Franky55/A24_ruler_Automne_2024/C3I_Equipe2_Documentation/TEMPLATE_A24.pptx

Ruler 2024

Présentation par : équipe 2
Laurie-Anne Boudreault
Francis Gratton
Groupe technique C3I

## Déroulement de la présentation

C3I – Équipe 2

Présentation
générale du projet

1

Présentation du projet

2

Respect des
contraintes

3

Gestion

4

5

Période de questions

6

Démonstration

## Présentation globale

- Tanné d’avoir plusieurs outils à trainer?

Ton professeur d’architecture est dégouté par tes projets avec des angles dégueu?

Fatigué que tes projets de bricolo ne fonctionnent pas?

Ruler 2024 est alors parfait pour toi!

## Présentation globale

- Avantages
- Amélioration de la productivité
- Réduction des outils nécessaires
- Meilleur rapport qualité-prix
- Adapté aux professionnels et étudiants
- Caractéristiques
- Traçage précis
- Mesure d’angles intégrée
- Ergonomique
- Portable
- Cibles
- Architectes
- Designers
- Bricoleurs

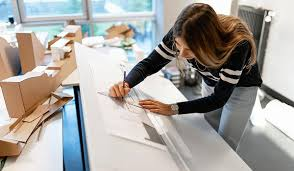
[picture p1: figure]
Structured for Success: Bachelor of Architecture - News - Truckee Meadows Community College
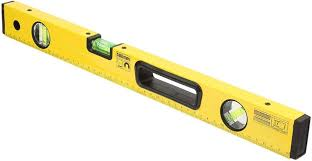
[picture p2: figure]
Règle de niveau à bulle en alliage d'aluminium haute précision 500 mm : Amazon.ca: Outils et Bricolage
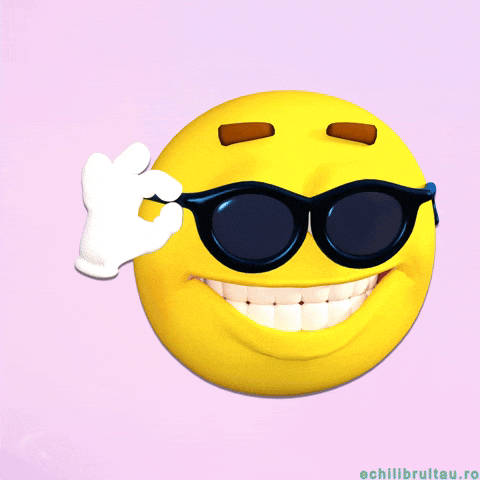
[picture p3: figure]
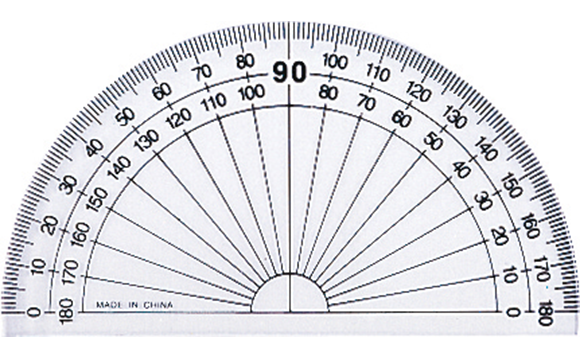
[picture p4: figure]
Rapporteur d'angles semi-circulaire - Brault & Bouthillier
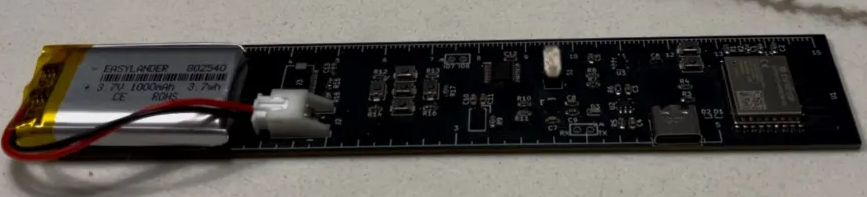
[picture p5: figure]

## Déroulement de la présentation

Présentation
générale du projet

1

Présentation du projet

2

Respect des
contraintes

3

Gestion

4

5

Période de questions

6

Démonstration

## Fonctionnalités

- ESP32-C3 WROOM
- USB-C (Prog et recharge)
- Sensor de distance
- IMU
- Battery 3.7V (Lithium Polymer)

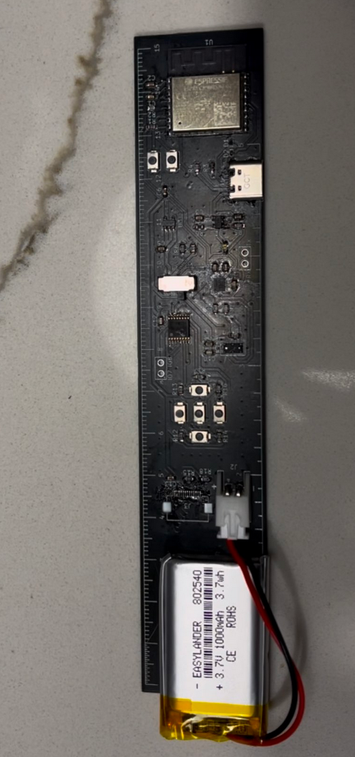
[picture p6: figure]

## Slide 7

Sample Footer Text

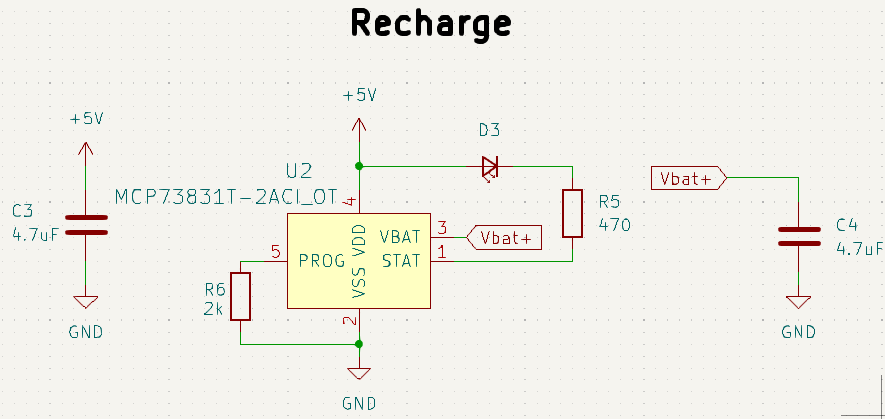
[picture p7: figure]
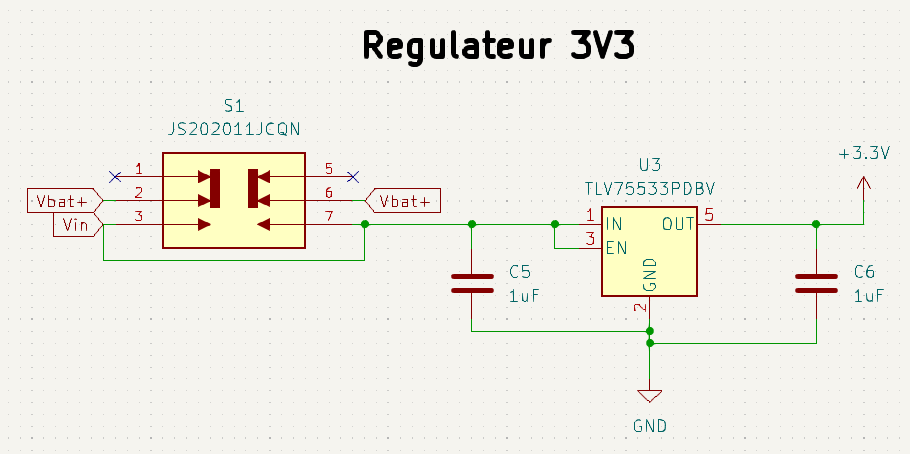
[picture p8: figure]

## Slide 8

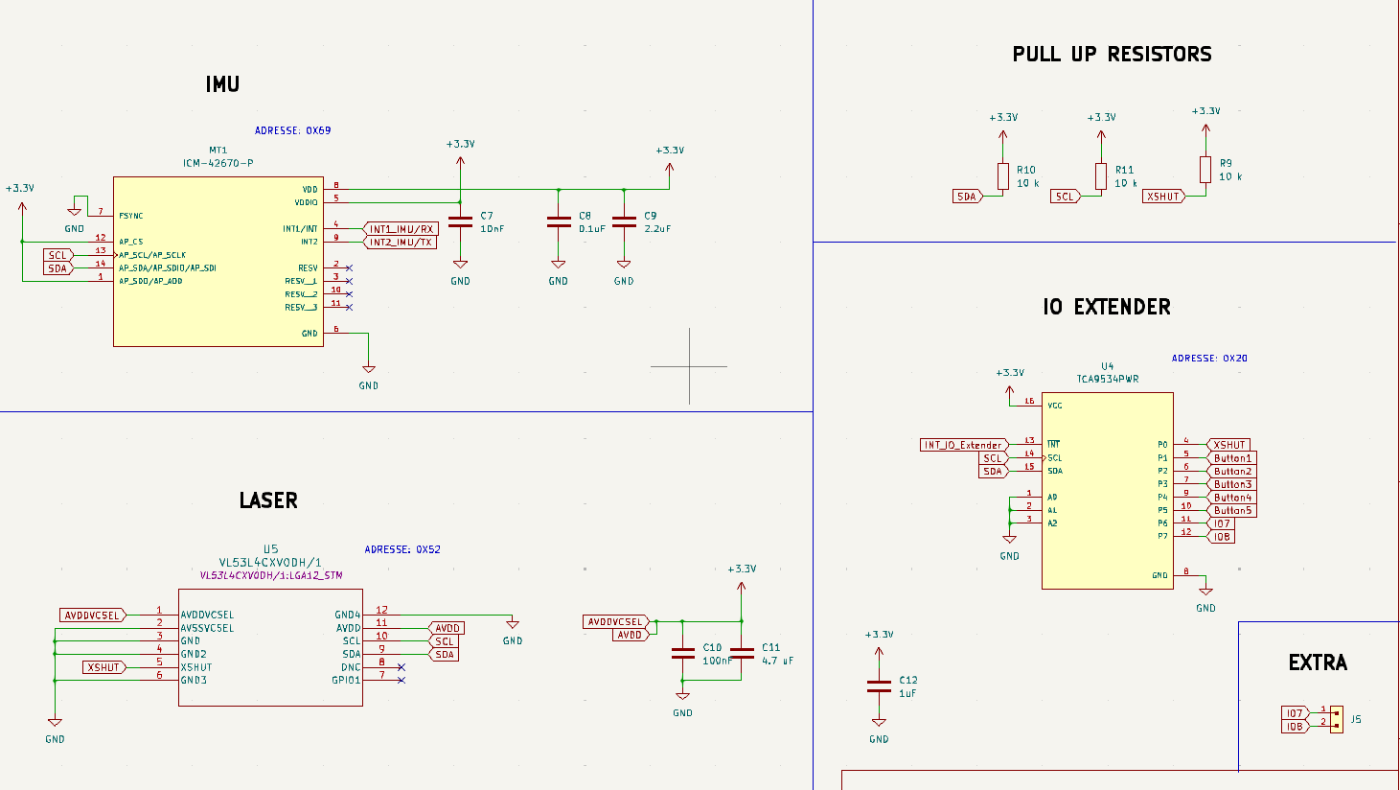
[picture p9: figure]

## Slide 9

Couche du dessous:

Couche du dessus:

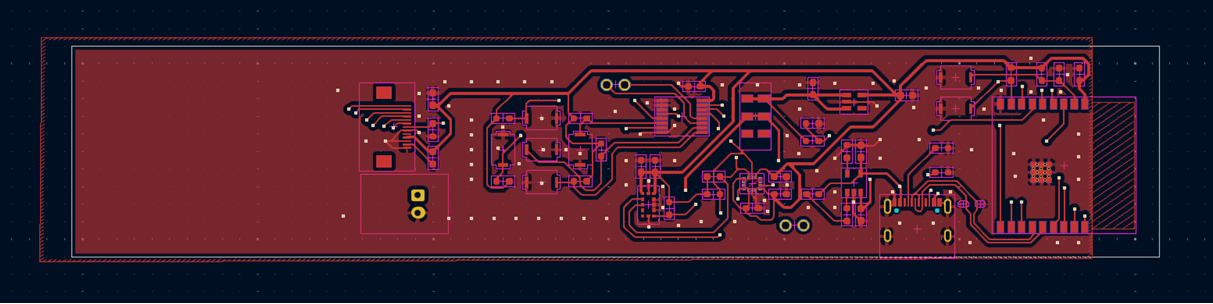
[picture p10: figure]
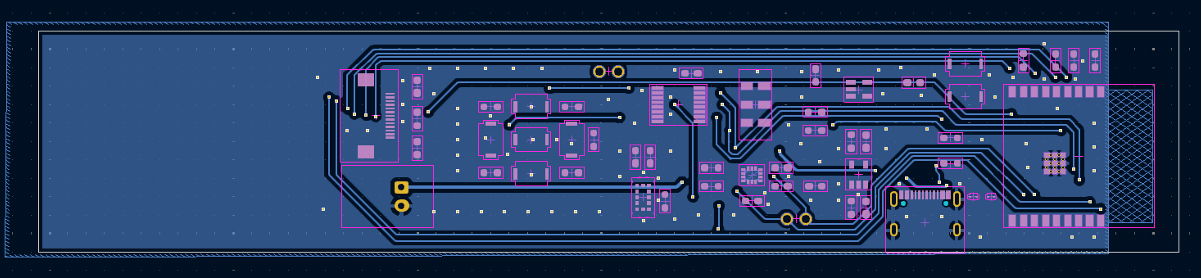
[picture p11: figure]

## Déroulement de la présentation

Présentation
générale du projet

1

Présentation du projet

2

Respect des
contraintes

3

Gestion

4

5

Période de questions

6

Démonstration

## Respect des contraintes

- Échéanciers
- Coût de développement
- Dimension

Coût du BOM

## Déroulement de la présentation

Présentation
générale du projet

1

Présentation du projet

2

Respect des
contraintes

3

Gestion

4

5

Période de questions

6

Démonstration

## Gestion

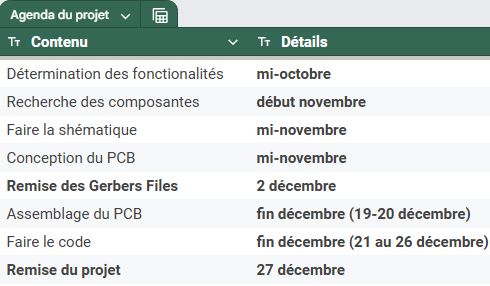
[picture p12: figure]

**Une moyenne de 3h par semaine a été accordée au projet.

## Déroulement de la présentation

Présentation
générale du projet

1

Présentation du projet

2

Respect des
contraintes

3

Gestion

4

5

Période de questions

6

Démonstration

## Déroulement de la présentation

Présentation
générale du projet

1

Présentation du projet

2

Respect des
contraintes

3

Gestion

4

5

Période de questions

6

Démonstration
