Franky55/A24_ruler_Automne_2024/C3I_Equipe2_Documentation/Bom/PCB_Regle_2024_ExcelCommande.pdf

Description | Component | for what | Part's Name | Part's Type | Price Per Unit | Quantity | Total | Manufacturer's ID | Digikey's ID | JLC's ID | Buying Link
| IMU | angle | ICM-42670-P | Sensor | $5.31 | 1 | $5.31 | ICM-42670-P | 1428-ICM-42670-PCT-ND | | https://www.digikey.ca/en/products/detail/tdk-invensense/ICM-42670-P/14319524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
| | | ESP32-C3-WROOM- 02-H4 | Microcontroller | $3.13 | 1 | $3.13 | ESP32-C3-WROOM- 02-H4
1965-ESP32-C3-WROOM- 02-H4CT-ND | https://www.digikey.ca/en/products/detail/espressif-systems/ESP32-C3-WROOM-02-H4/14553033 Chargeur pour la battery | Chargeur | For Battery | MCP73831T-2ACI/OT | Component | $1.19 | 1 | $1.19 | MCP73831T-2ACI/OT | MCP73831T-2ACI/OTCT-ND | https://www.digikey.com/en/products/detail/microchip-technology/MCP73831T-2ACI-OT/964301 CAP CER 0.1UF 50V X7R 0603 | CAP 0.1uF | IMU | Capacitor | Component | $0.04 | 10 | $0.37 | CL10B104KB8NNNC | 1276-1000-1-ND | https://www.digikey.ca/en/products/detail/samsung-electro-mechanics/CL10B104KB8NNNC/3886658 CAP CER 2.2UF 16V X5R 0603 | CAP 2.2uF | IMU | Capacitor | Component | $0.04 | 10 | $0.37 | CL10A225KO8NNNC | 1276-1040-1-ND | https://www.digikey.ca/en/products/detail/samsung-electro-mechanics/CL10A225KO8NNNC/3886698 CAP CER 10000PF 50V X7R 0603 | CAP 10nF | IMU | Capacitor | Component | $0.04 | 10 | $0.37 | CL10B103KB8NNNC | 1276-1009-1-ND | https://www.digikey.ca/en/products/detail/samsung-electro-mechanics/CL10B103KB8NNNC/3886667
IC REG LINEAR 3.3V 500MA SOT23-5 | Regulator 3.3V | Voltage 3.3V | Regulator 3.3V | Component | $0.32 | 2 | $0.64 | TLV75533PDBVR | 296-50411-1-ND | https://www.digikey.ca/en/products/detail/texas-instruments/TLV75533PDBVR/9356541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
laser | | distance mesuring | VL53L4CXV0DH/1 | Sensor | $6.97 | 1 | $6.97 | VL53L4CXV0DH/1
497-VL53L4CXV0DH/1CT- ND | https://www.digikey.ca/en/products/detail/stmicroelectronics/VL53L4CXV0DH-1/16123777 CONN HEADER R/A 2POS 2.5MM | Connecteur batt Connecteur batt | S2B-XH-A-1 | Connector | $0.31 | 1 | $0.31 | S2B-XH-A-1 | 455-S2B-XH-A-1-ND | https://www.digikey.ca/en/products/detail/jst-sales-america-inc/S2B-XH-A-1/9961922 CONN RCP USB2.0 TYP C 24P SMD RA | USB-C | Connecting | USB4105-GF-A | Connector | $1.53 | 1 | $1.53 | USB4105-GF-A | 2073-USB4105-GF-ACT-ND | https://www.digikey.ca/en/products/detail/gct/USB4105-GF-A/11198441
IC XPNDR 400KHZ I2C 16TSSOP | I/O Expander | Manque de I/O | TCA9534PWR | Component | $1.88 | 1 | $1.88 | TCA9534PWR | 296-40574-1-ND | https://www.digikey.ca/en/products/detail/texas-instruments/TCA9534PWR/5004966 SWITCH TACTILE SPST-NO 0.05A 50V | Button | Screen/Boot/reset | CS1213AGF260 | Component | $0.63 | 7 | $4.41 | CS1213AGF260 | 2449-CS1213AGF260CT-ND | https://www.digikey.ca/en/products/detail/cit-relay-and-switch/CS1213AGF260/16607763 SWITCH SLIDE DPDT 300MA 6V | Switch | Power ON/OFF | JS202011JAQN | Component | $1.30 | 1 | $1.30 | JS202011JAQN | CKN10722CT-ND | https://www.digikey.ca/en/products/detail/c-k/JS202011JAQN/6137629 TVS DIODE 5VWM 12.3VC SOD923 | TVS | Protection ;) | ESD9X5.0ST5G | Component | $0.15 | 2 | $0.30 | ESD9X5.0ST5G | ESD9X5.0ST5GOSCT-ND | https://www.digikey.ca/en/products/detail/onsemi/ESD9X5-0ST5G/1476616
LED GREEN CLEAR 0603 SMD | LED | Chargement | 150060VS75000 | Component | $0.23 | 1 | $0.23 | 150060VS75000 | 732-4980-1-ND | https://www.digikey.ca/en/products/detail/w%C3%BCrth-elektronik/150060VS75000/4489906
resistance 10K | resistor | resistor | RC0603FR-0710KL | Component | $0.02 | 10 | $0.19 | RC0603FR-0710KL | 311-10.0KHRCT-ND | https://www.digikey.ca/en/products/detail/yageo/RC0603FR-075K1L/727268
resistance 5k | resistor | resistor | RC0603FR-075K1L | Component | $0.02 | 10 | $0.19 | RC0603FR-075K1L | 311-5.10KHRCT-ND | https://www.digikey.ca/en/products/detail/yageo/RC0603FR-075K1L/727268
resistance 2k | resistor | resistor | ERJ-3EKF2001V | Component | $0.16 | 1 | $0.16 | ERJ-3EKF2001V | P2.00KHCT-ND | https://www.digikey.ca/en/products/detail/yageo/RC0603FR-075K1L/727268
resistance 100k | resistor | resistor | RMCF0603FT100K | Component | $0.16 | 1 | $0.16 | RMCF0603FT100K | RMCF0603FT100KCT-ND | https://www.digikey.ca/en/products/detail/yageo/RC0603FR-075K1L/727268
resistance 300k | resistor | resistor | RMCF0603FT300K | Component | $0.16 | 1 | $0.16 | RMCF0603FT300K | RMCF0603FT300KCT-ND | https://www.digikey.ca/en/products/detail/yageo/RC0603FR-075K1L/727268
resistance 470 ohms | resistor | resistor | RC0603JR-07470RL | Component | $0.02 | 10 | | RC0603JR-07470RL | 311-470GRCT-ND | https://www.digikey.ca/en/products/detail/yageo/RC0603JR-07470RL/726791
resistance 20-25 ohms | resistor | resistor | RC0603JR-0720RL | Component | $0.02 | 10 | | RC0603JR-0720RL | 311-20GRCT-ND | https://www.digikey.ca/en/products/detail/yageo/RC0603JR-0720RL/726739
resistance 0 ohms | resistor | resistor | RMCF0603ZT0R00 | Component | $0.02 | 10 | $0.20 | RMCF0603ZT0R00 | RMCF0603ZT0R00CT-ND | https://www.digikey.ca/en/products/detail/stackpole-electronics-inc/RMCF0603ZT0R00/1756908
capacitor 4,7 uF | capacitor | capacitor | CL10A475KP8NNNC Component | $0.05 | 10 | CL10A475KP8NNNC 1276-1044-1-ND | https://www.digikey.ca/en/products/detail/samsung-electro-mechanics/CL10A475KP8NNNC/3886702
capacitor 1uF | capacitor | capacitor | CL10B105KP8NNNC | Component | $0.05 | 10 | $0.47 | CL10B105KP8NNNC 1276-1946-1-ND | https://www.digikey.ca/en/products/detail/samsung-electro-mechanics/CL10B105KP8NNNC/3887604
total | $29.84
