Franky55/A24_ruler_Automne_2024/C3I_Equipe2_Documentation/SchematicRuler2024FrankLau.pdf

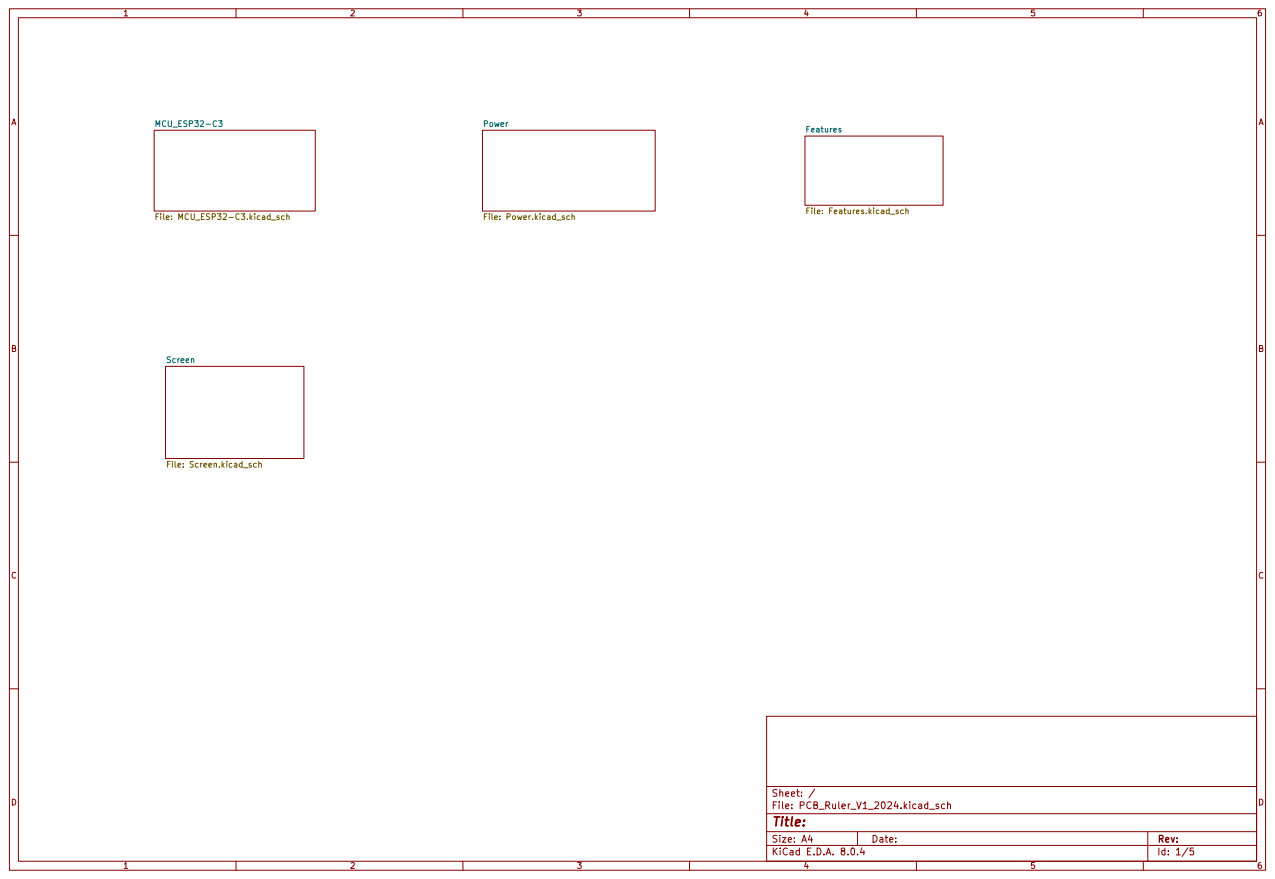
[picture p22: page 1]

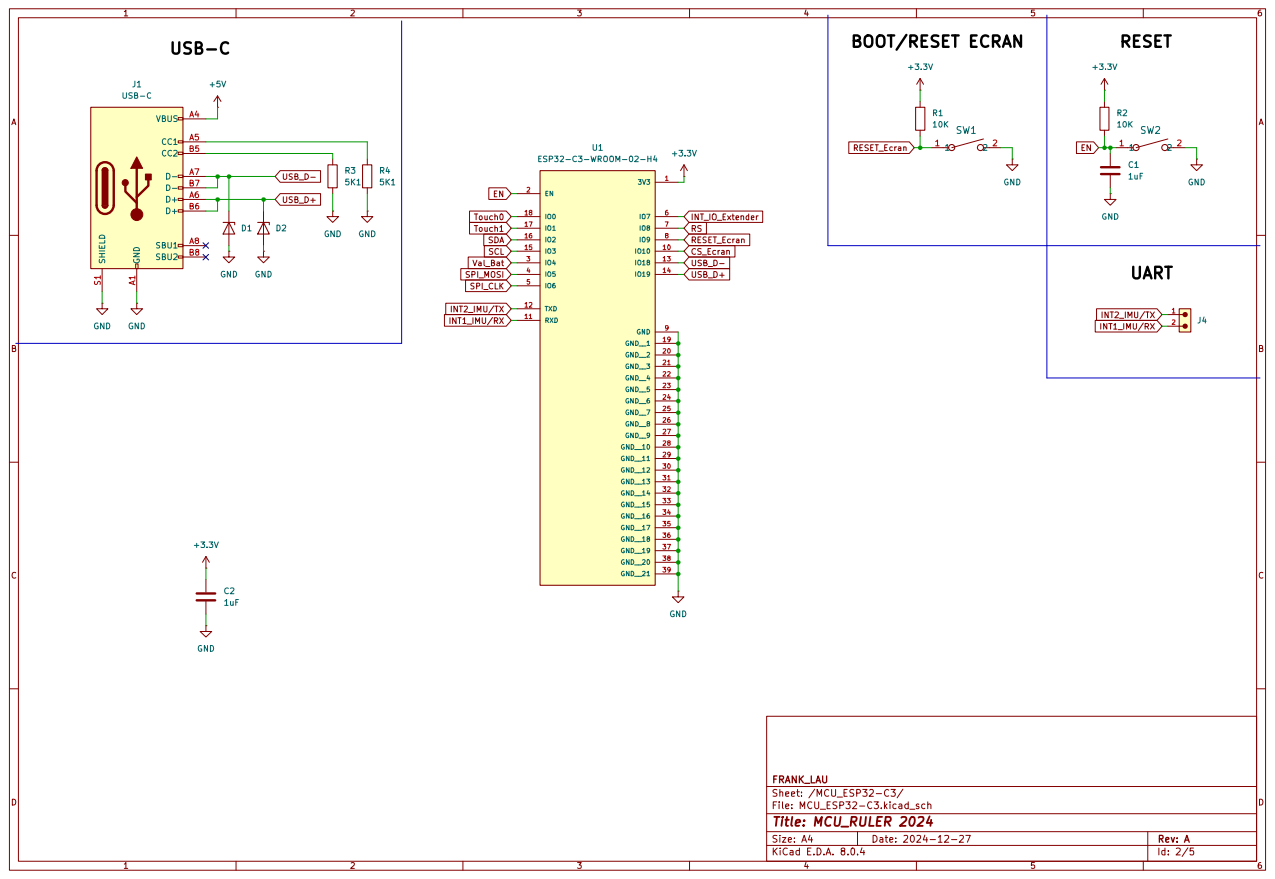
[picture p23: page 2]

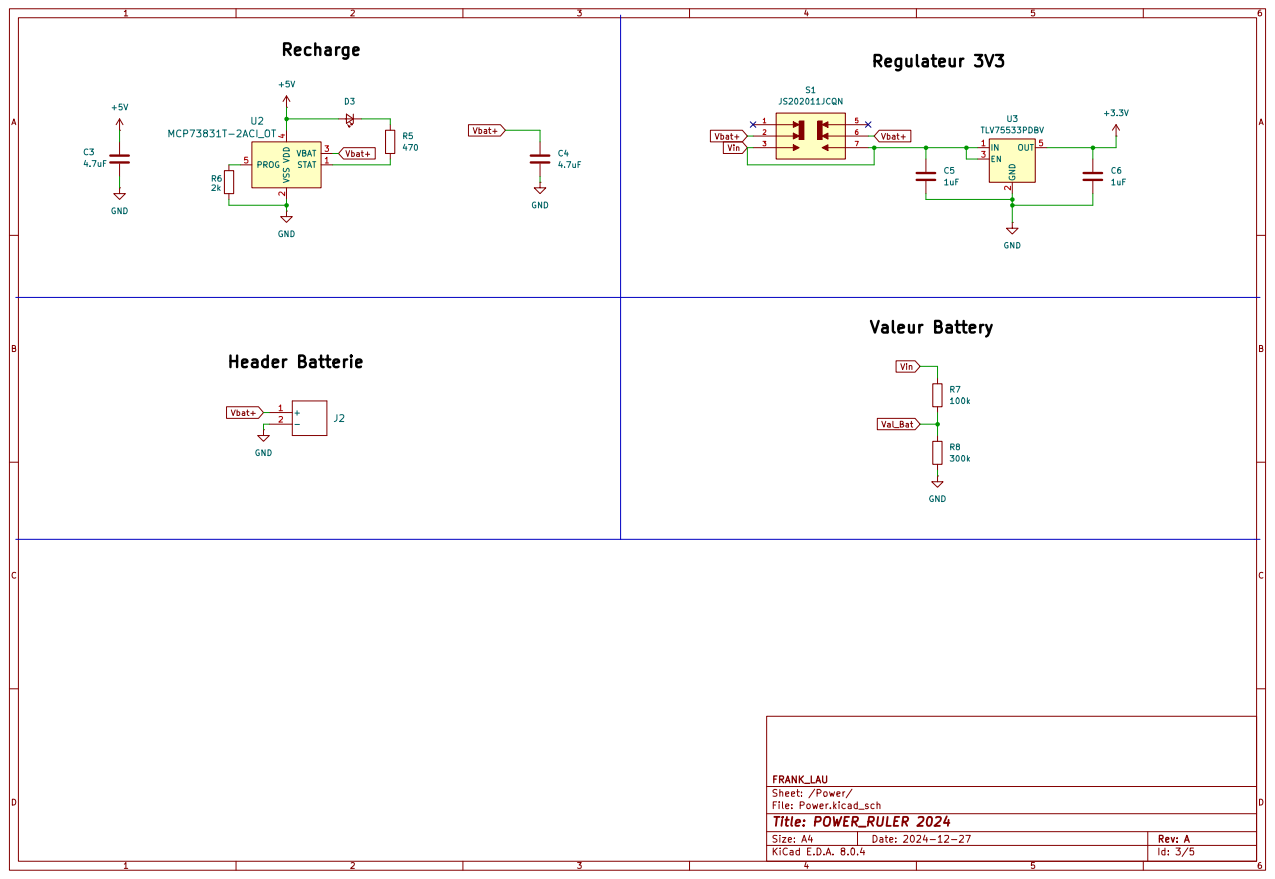
[picture p24: page 3]

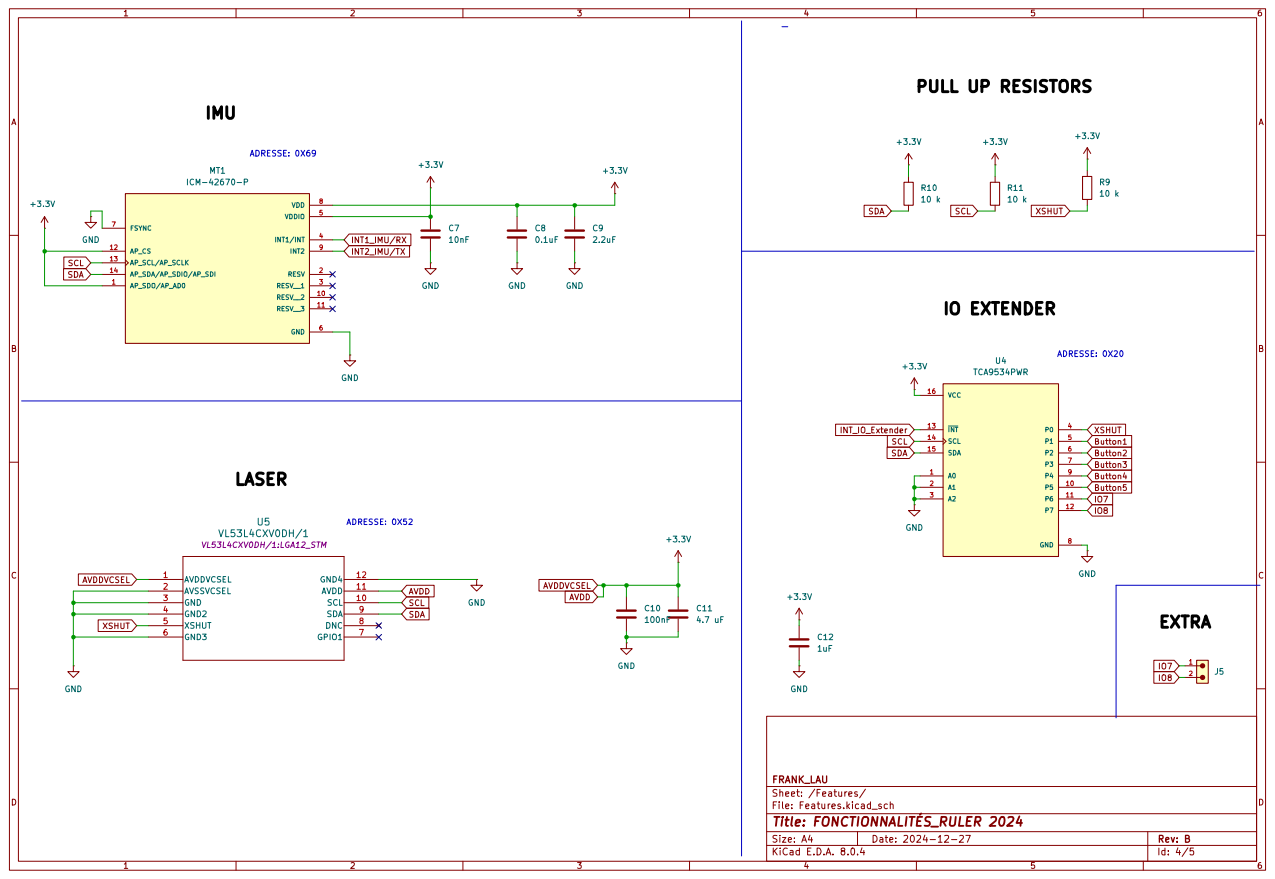
[picture p25: page 4]

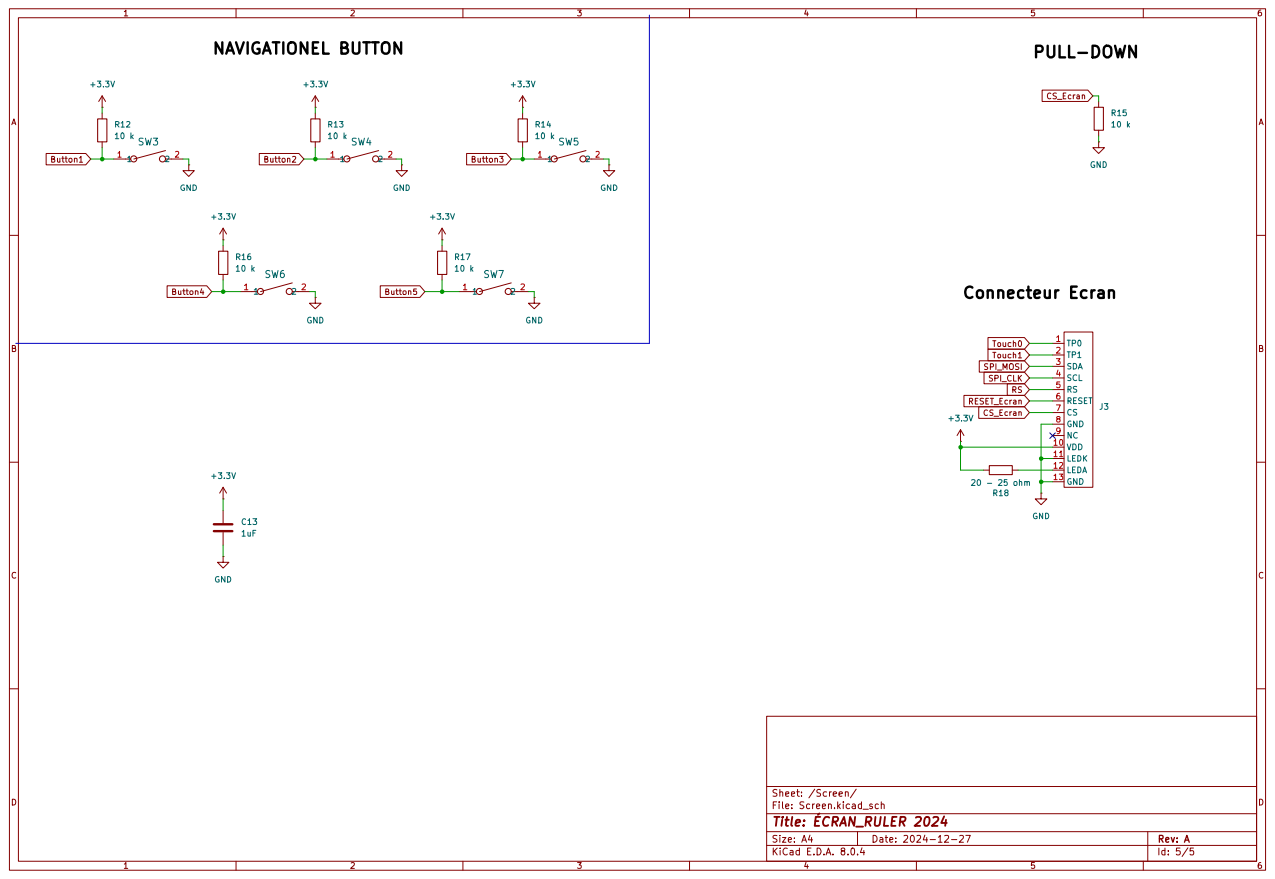
[picture p26: page 5]
