Franky55/A24_ruler_Automne_2024/elec/PCB_Ruler_V1_2024/PCB_Ruler_V1_2024.kicad_pcb

## KiCad design elec/PCB_Ruler_V1_2024/PCB_Ruler_V1_2024.kicad_pcb (2024-12-28)

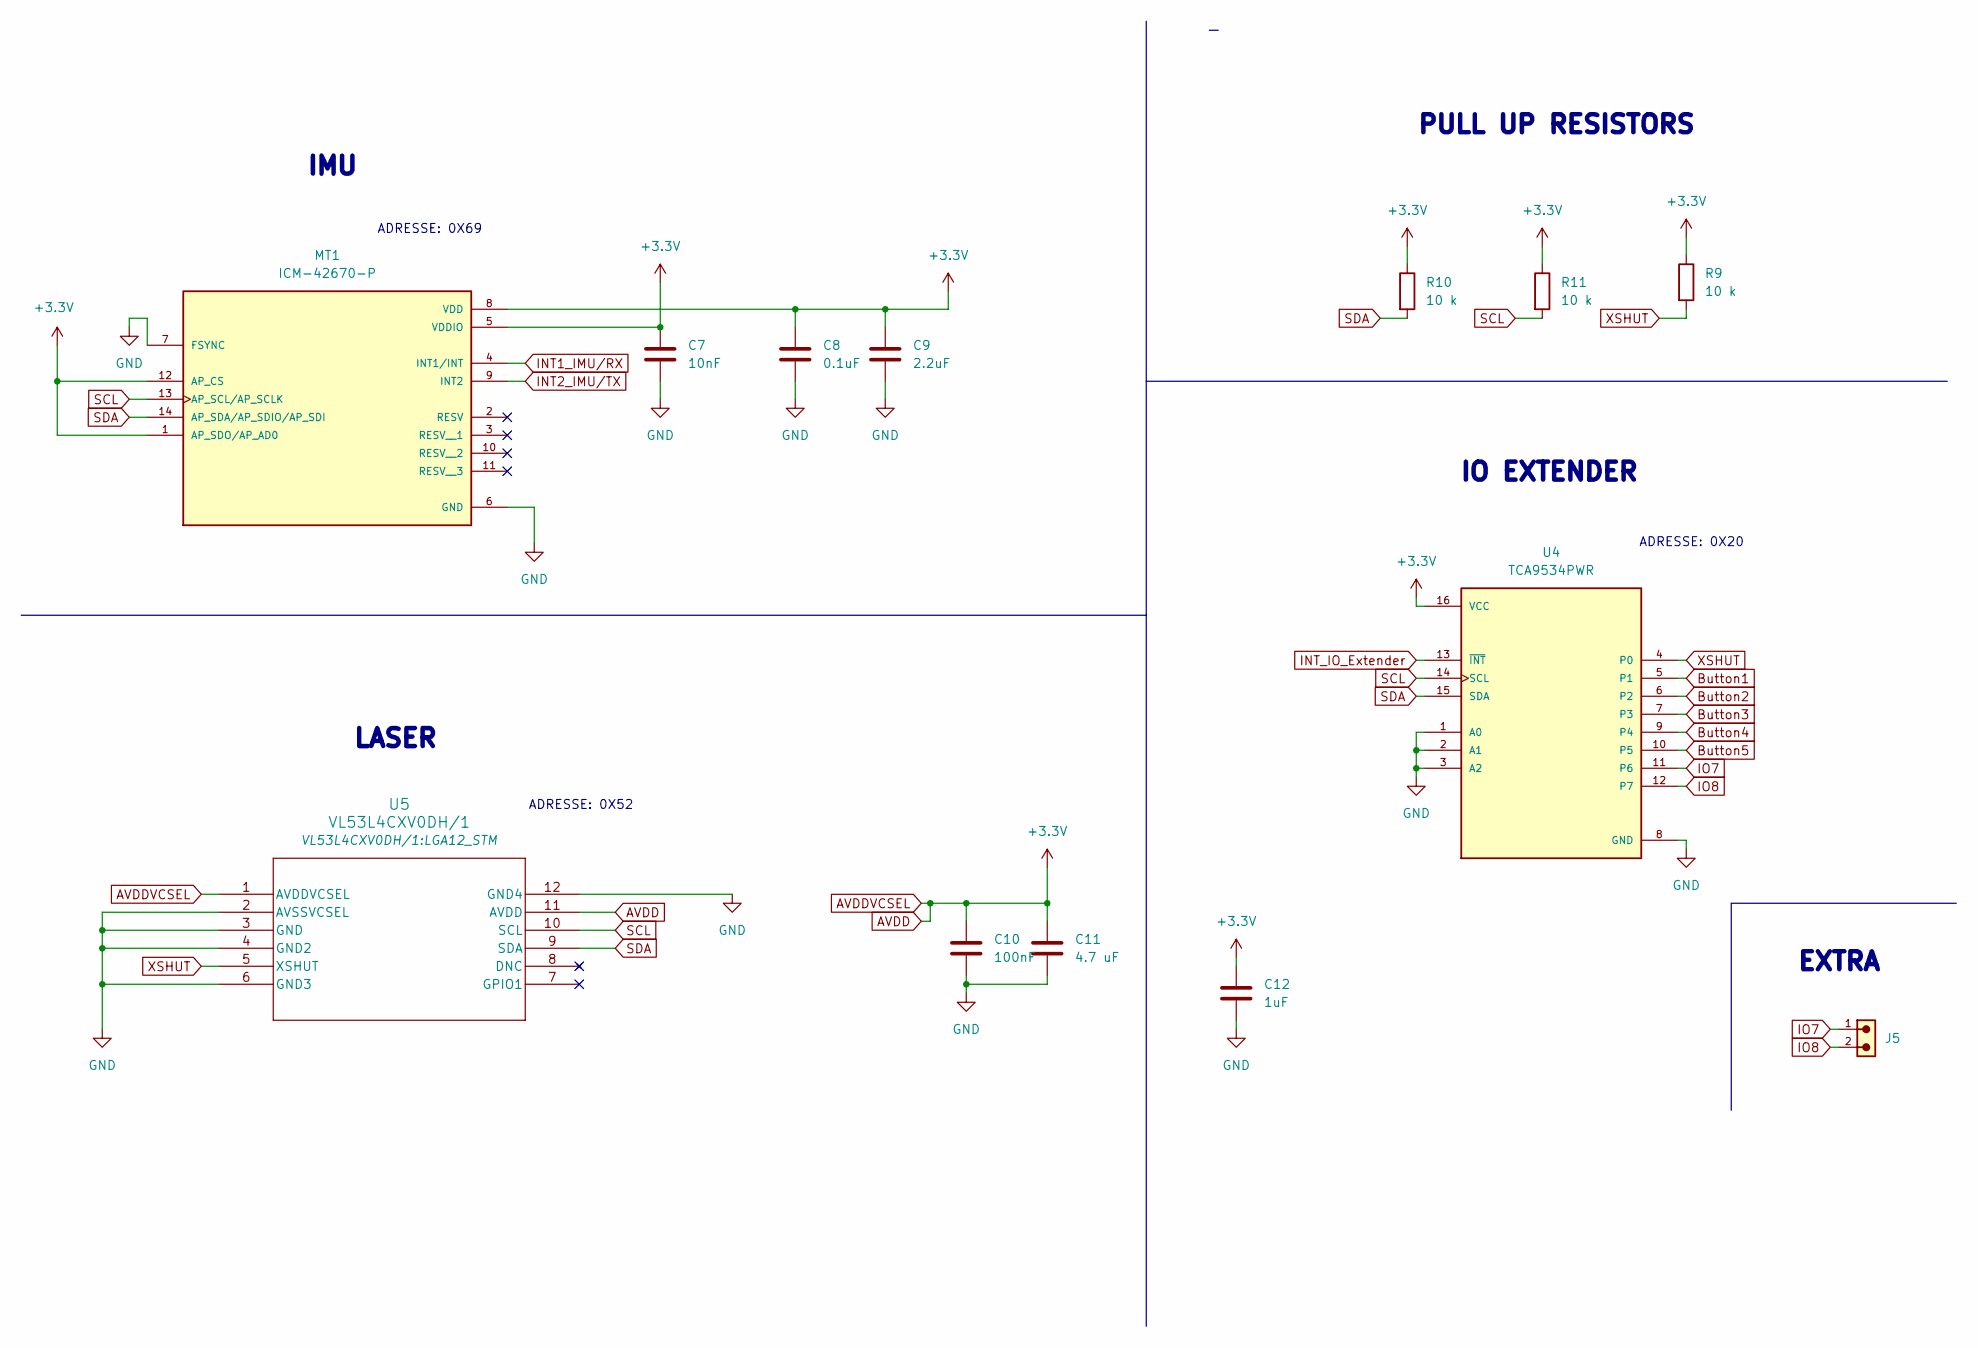
[picture p27: schematic Features.kicad_sch, FONCTIONNALITÉS_RULER 2024]

Parts:
C7: 10nF; C_0603_1608Metric_Pad1.08x0.95mm_HandSolder
C8: 0.1uF; C_0603_1608Metric_Pad1.08x0.95mm_HandSolder
C9: 2.2uF; C_0603_1608Metric_Pad1.08x0.95mm_HandSolder
C10: 100nF; C_0603_1608Metric_Pad1.08x0.95mm_HandSolder
C11: 4.7 uF; C_0603_1608Metric_Pad1.08x0.95mm_HandSolder
C12: 1uF; C_0603_1608Metric_Pad1.08x0.95mm_HandSolder
J5: 61300211121; PART-NUMBER 61300211121
MT1: ICM-42670-P; XDCR_ICM-42670-P; PARTREV 1.1
R9, R10, R11: 10 k; R_0603_1608Metric_Pad0.98x0.95mm_HandSolder
U4: TCA9534PWR; SOP65P640X120-16N; PARTREV D
U5: VL53L4CXV0DH/1; LGA12_STM

Connections:
AVDD: C7.1, C8.1, C9.1, C10.1, C11.1, C12.1, MT1.1 (AP_SDO/AP_AD0), MT1.5 (VDDIO), MT1.8 (VDD), MT1.12 (AP_CS), R9.1, R10.1, R11.1, U4.16 (VCC), U5.1 (AVDDVCSEL), U5.11 (AVDD); also elsewhere on the board
Button1: U4.5 (P1); also elsewhere on the board
Button2: U4.6 (P2); also elsewhere on the board
Button3: U4.7 (P3); also elsewhere on the board
Button4: U4.9 (P4); also elsewhere on the board
Button5: U4.10 (P5); also elsewhere on the board
GND: C7.2, C8.2, C9.2, C10.2, C11.2, C12.2, MT1.6 (GND), MT1.7 (FSYNC), U4.1 (A0), U4.2 (A1), U4.3 (A2), U4.8 (GND), U5.2 (AVSSVCSEL), U5.3 (GND), U5.4 (GND2), U5.6 (GND3), U5.12 (GND4); also elsewhere on the board
INT1_IMU/RX: MT1.4 (INT1/INT); also elsewhere on the board
INT2_IMU/TX: MT1.9 (INT2); also elsewhere on the board
INT_IO_Extender: U4.13 (~INT); also elsewhere on the board
IO7: J5.1, U4.11 (P6)
IO8: J5.2, U4.12 (P7)
SCL: MT1.13 (AP_SCL/AP_SCLK), R11.2, U4.14 (SCL), U5.10 (SCL); also elsewhere on the board
SDA: MT1.14 (AP_SDA/AP_SDIO/AP_SDI), R10.2, U4.15 (SDA), U5.9 (SDA); also elsewhere on the board
XSHUT: R9.2, U4.4 (P0), U5.5 (XSHUT)

Notes on the sheet:
IMU
ADRESSE: 0X20
ADRESSE: 0X52
ADRESSE: 0X69
IO EXTENDER
LASER
EXTRA
PULL UP RESISTORS

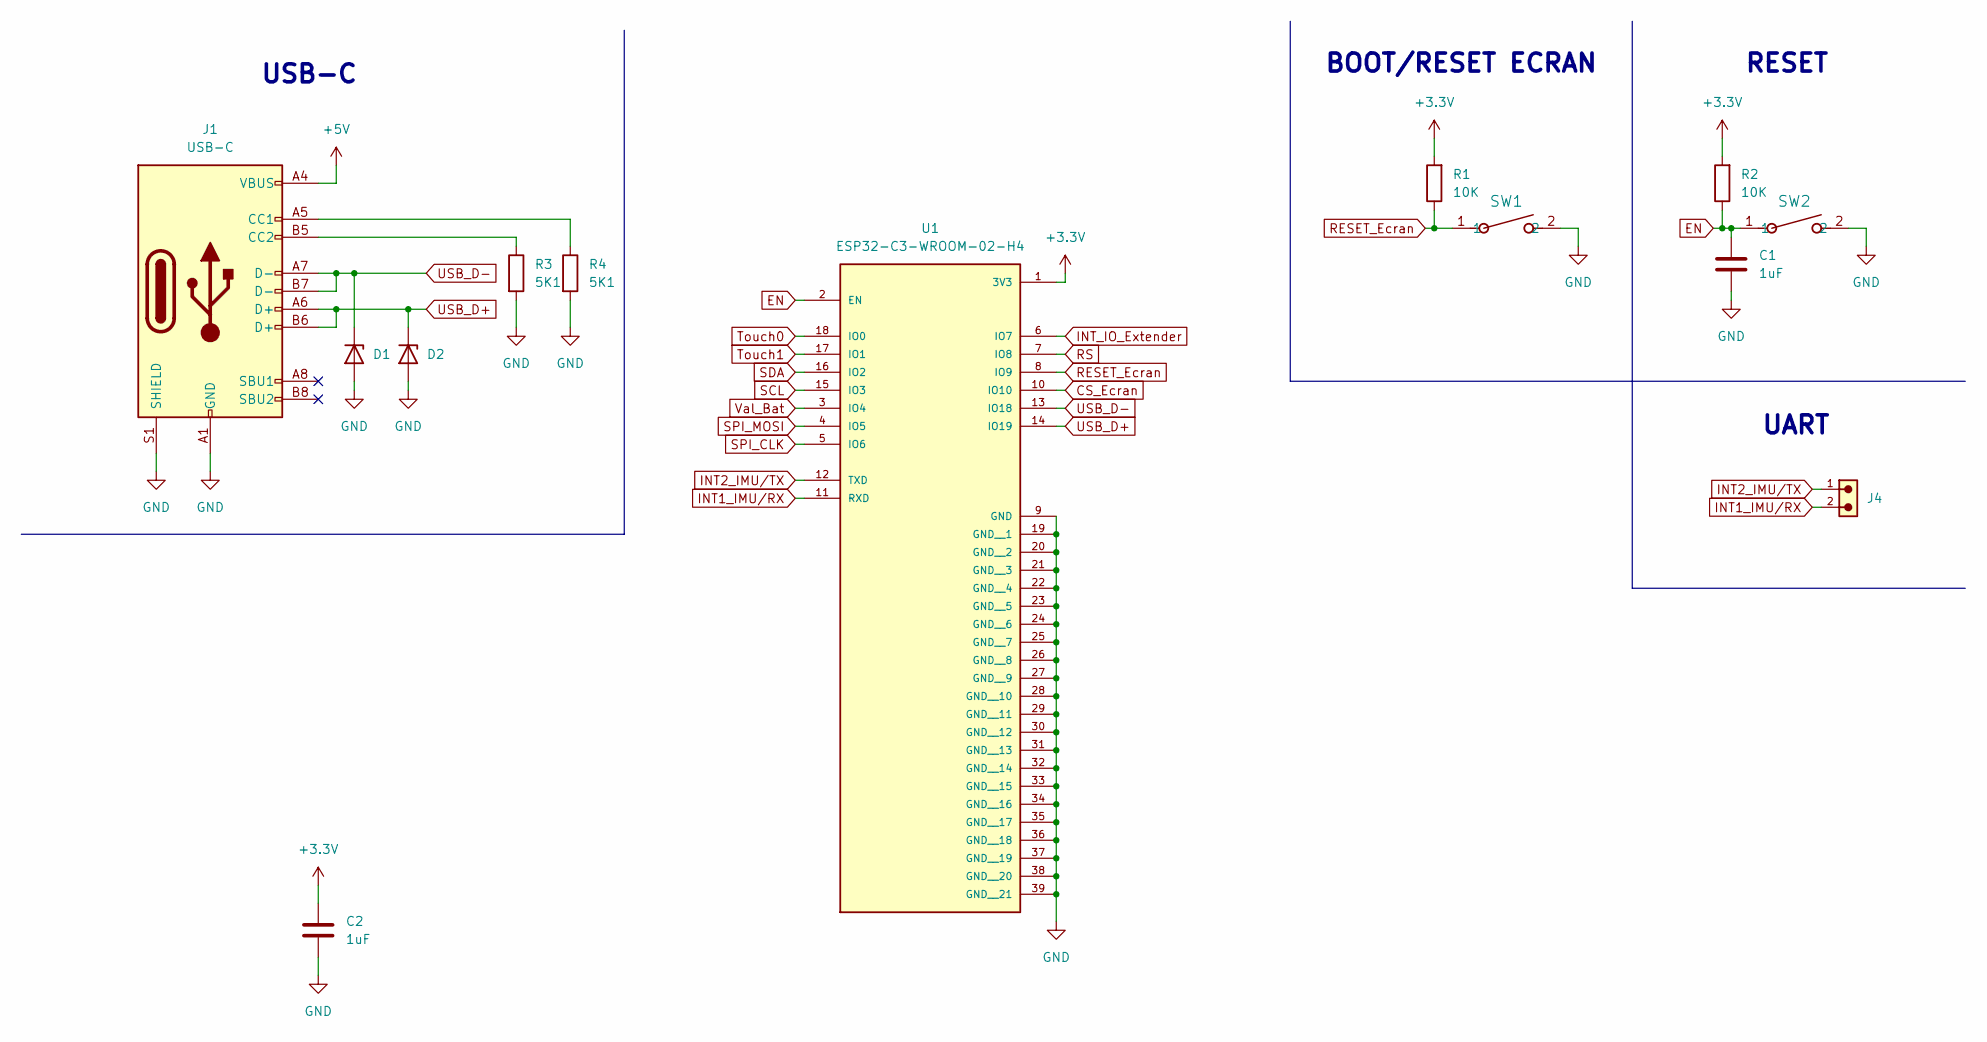
[picture p28: schematic MCU_ESP32-C3.kicad_sch, MCU_RULER 2024]

Parts:
C1, C2: 1uF; C_0603_1608Metric_Pad1.08x0.95mm_HandSolder
D1, D2: D_Zener; D_SOD-923
J1: USB-C; USB_C_Receptacle_G-Switch_GT-USB-7010ASV
J4: 61300211121; PART-NUMBER 61300211121
R1, R2: 10K; R_0603_1608Metric_Pad0.98x0.95mm_HandSolder
R3, R4: 5K1; R_0603_1608Metric_Pad0.98x0.95mm_HandSolder
SW1, SW2: CS1213AGF260; SW_CS1213AGF260_CRS
U1: ESP32-C3-WROOM-02-H4; MODULE_ESP32-C3-WROOM-02-H4

Connections:
+5V: J1.A4 (VBUS), J1.A9 (VBUS), J1.B4 (VBUS), J1.B9 (VBUS); also elsewhere on the board
AVDD: C2.1, R1.2, R2.2, U1.1 (3V3); also elsewhere on the board
CS_Ecran: U1.10 (IO10); also elsewhere on the board
EN: C1.1, R2.1, SW2.1, U1.2 (EN)
GND: C1.2, C2.2, D1.2 (A), D2.2 (A), J1.A1 (GND), J1.A12 (GND), J1.B1 (GND), J1.B12 (GND), J1.S1 (SHIELD), R3.2, R4.2, SW1.2, SW2.2, U1.9 (GND), U1.19 (GND__1), U1.20 (GND__2), U1.21 (GND__3), U1.22 (GND__4), U1.23 (GND__5), U1.24 (GND__6), U1.25 (GND__7), U1.26 (GND__8), U1.27 (GND__9), U1.28 (GND__10), U1.29 (GND__11), U1.30 (GND__12), U1.31 (GND__13), U1.32 (GND__14), U1.33 (GND__15), U1.34 (GND__16), U1.35 (GND__17), U1.36 (GND__18), U1.37 (GND__19), U1.38 (GND__20), U1.39 (GND__21); also elsewhere on the board
INT1_IMU/RX: J4.2, U1.11 (RXD); also elsewhere on the board
INT2_IMU/TX: J4.1, U1.12 (TXD); also elsewhere on the board
INT_IO_Extender: U1.6 (IO7); also elsewhere on the board
unnamed: J1.A5 (CC1), R4.1
unnamed: J1.B5 (CC2), R3.1
RESET_Ecran: R1.1, SW1.1, U1.8 (IO9); also elsewhere on the board
RS: U1.7 (IO8); also elsewhere on the board
SCL: U1.15 (IO3); also elsewhere on the board
SDA: U1.16 (IO2); also elsewhere on the board
SPI_CLK: U1.5 (IO6); also elsewhere on the board
SPI_MOSI: U1.4 (IO5); also elsewhere on the board
Touch0: U1.18 (IO0); also elsewhere on the board
Touch1: U1.17 (IO1); also elsewhere on the board
USB_D+: D2.1 (K), J1.A6 (D+), J1.B6 (D+), U1.14 (IO19)
USB_D-: D1.1 (K), J1.A7 (D-), J1.B7 (D-), U1.13 (IO18)
Val_Bat: U1.3 (IO4); also elsewhere on the board

Notes on the sheet:
RESET
UART
USB-C
BOOT/RESET ECRAN

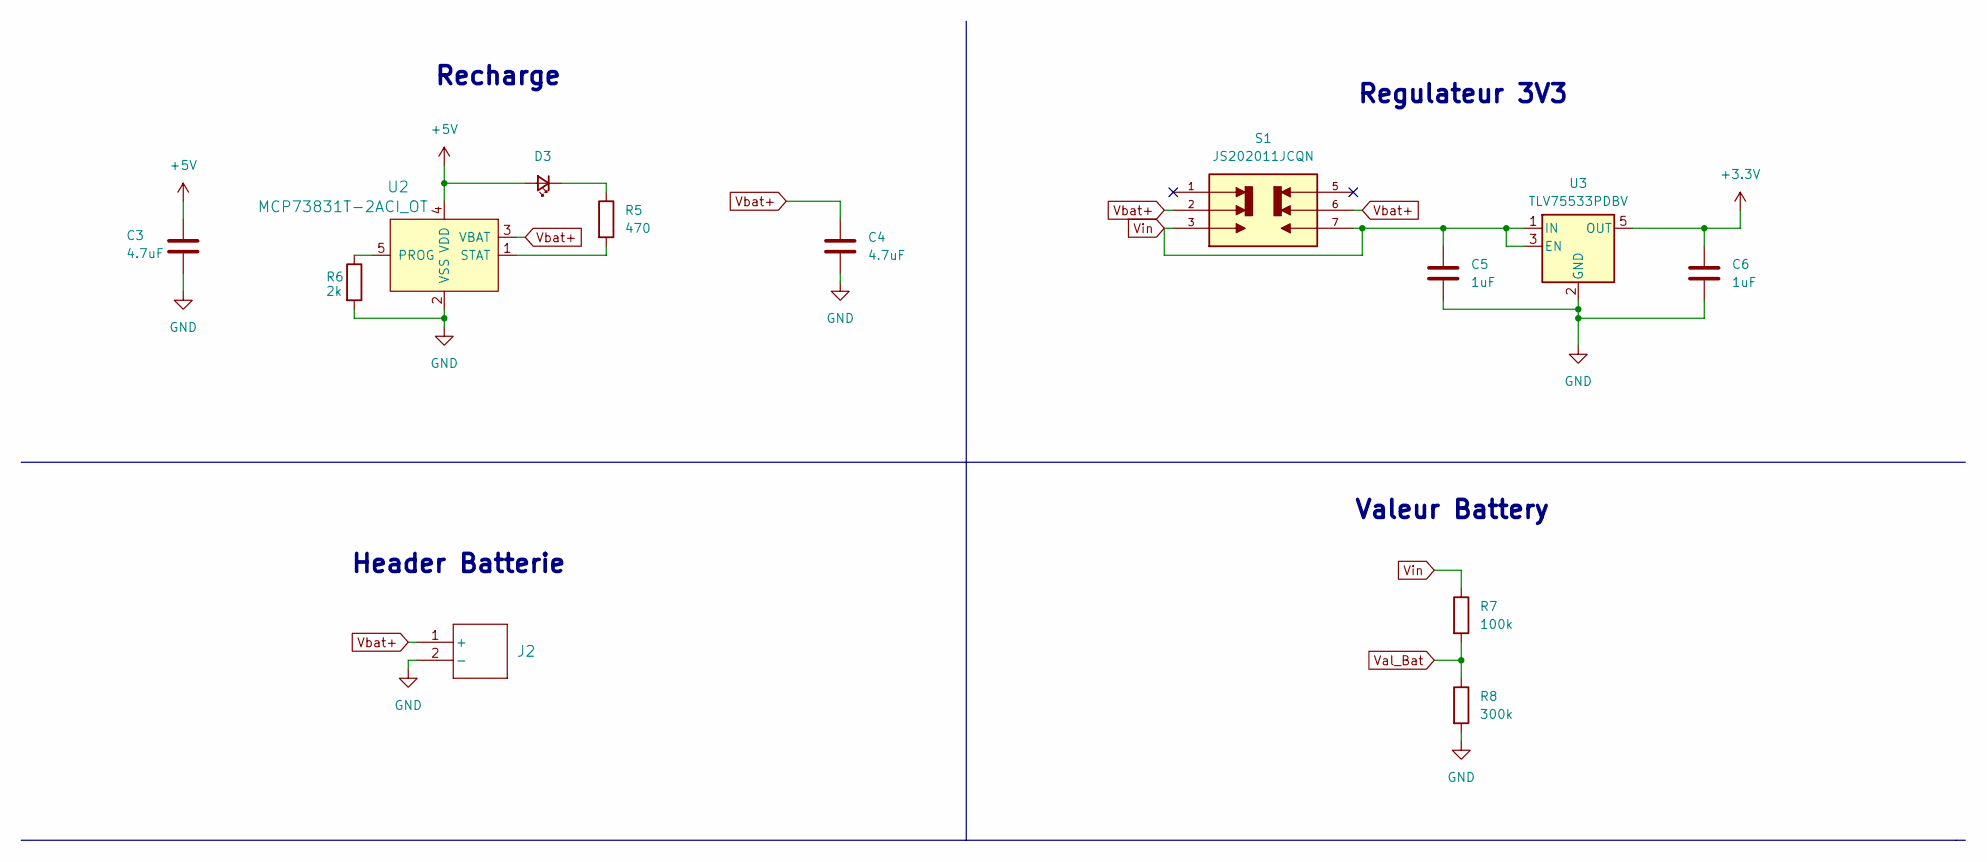
[picture p29: schematic Power.kicad_sch, POWER_RULER 2024]

Parts:
C3, C4: 4.7uF; C_0603_1608Metric_Pad1.08x0.95mm_HandSolder
C5, C6: 1uF; C_0603_1608Metric_Pad1.08x0.95mm_HandSolder
D3: LED_Small; LED_0603_1608Metric_Pad1.05x0.95mm_HandSolder
J2: S2B-XH-A-1LFSN; JST_XH_S2B-XH-A-1_1x02_P2.50mm_Horizontal
R5: 470; R_0603_1608Metric_Pad0.98x0.95mm_HandSolder
R6: 2k; R_0603_1608Metric_Pad0.98x0.95mm_HandSolder
R7: 100k; R_0603_1608Metric_Pad0.98x0.95mm_HandSolder
R8: 300k; R_0603_1608Metric_Pad0.98x0.95mm_HandSolder
S1: JS202011JCQN; SW_JS202011JCQN; PARTREV 11 Nov 19
U2: MCP73831T-2ACI_OT; SOT-753; MPN MCP73831T-2ACI/OT; Digi-Key_PN MCP73831T-2ACI/OTCT-ND
U3: TLV75533PDBV; SOT-23-5

Connections:
+5V: C3.1, D3.2 (A), U2.4 (VDD); also elsewhere on the board
AVDD: C6.1, U3.5 (OUT); also elsewhere on the board
GND: C3.2, C4.2, C5.2, C6.2, J2.2 (-), R6.2, R8.2, U2.2 (VSS), U3.2 (GND); also elsewhere on the board
unnamed: D3.1 (K), R5.1
unnamed: R6.1, U2.5 (PROG)
unnamed: R5.2, U2.1 (STAT)
Val_Bat: R7.2, R8.1; also elsewhere on the board
Vbat+: C4.1, J2.1 (+), S1.2, S1.6, U2.3 (VBAT)
Vin: C5.1, R7.1, S1.3, S1.7, U3.1 (IN), U3.3 (EN)

Notes on the sheet:
Valeur Battery
Header Batterie
Regulateur 3V3
Recharge

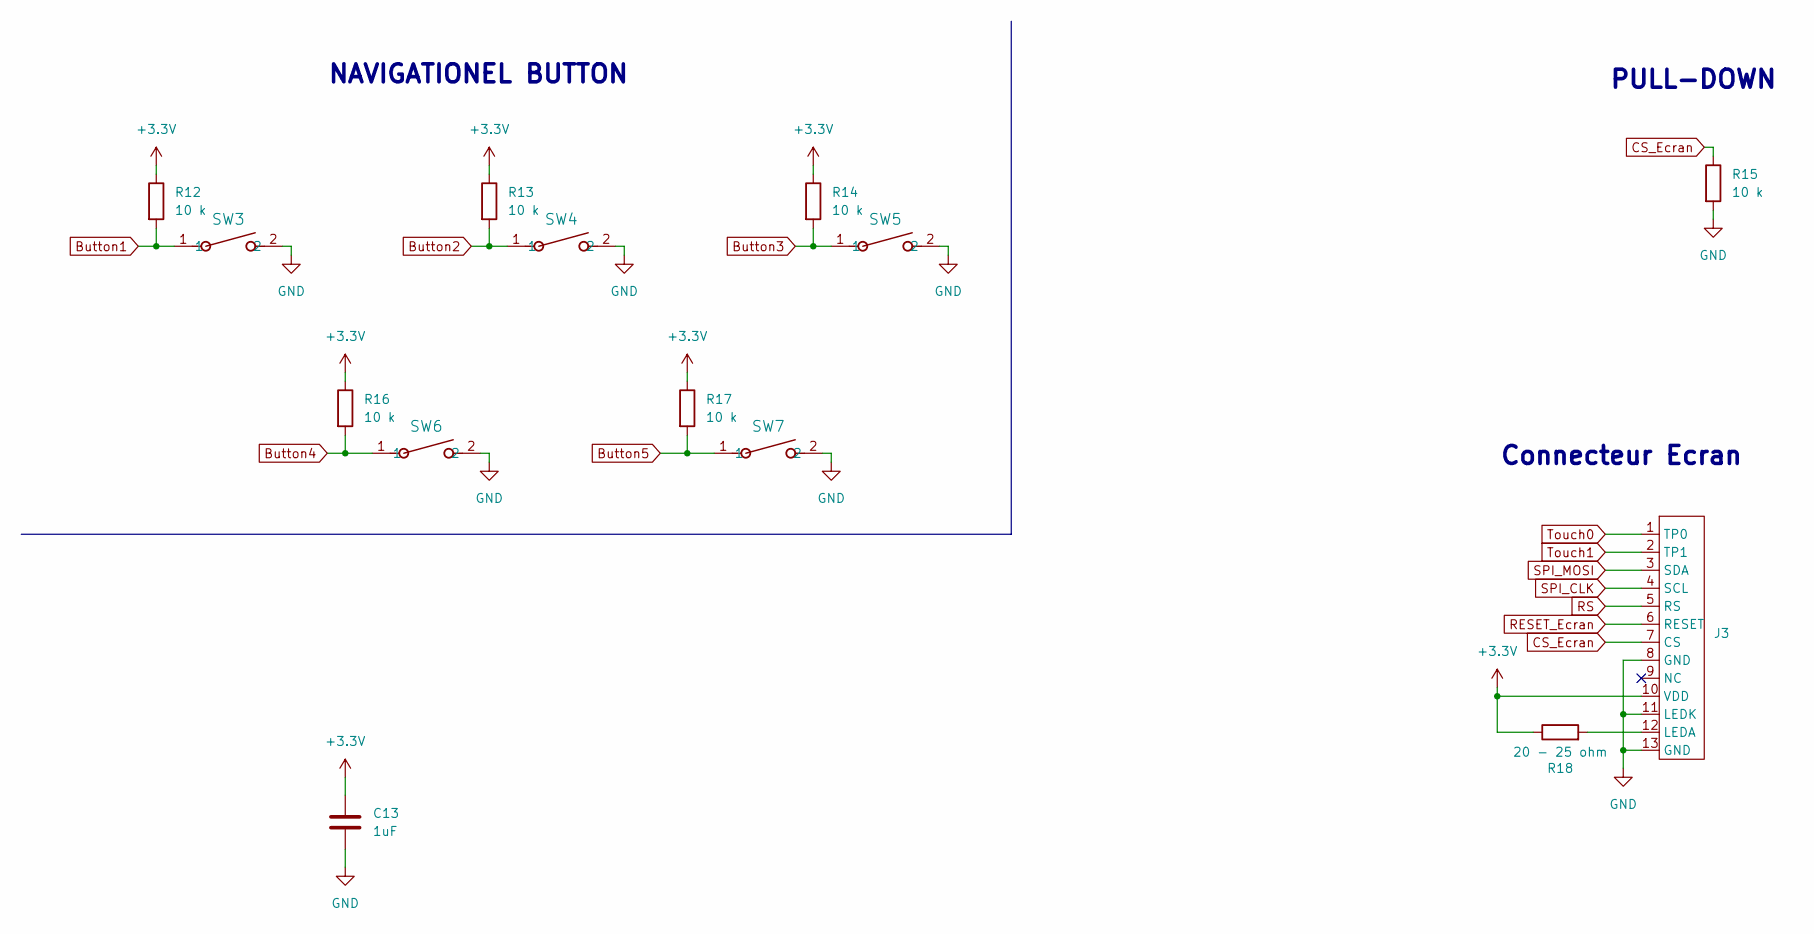
[picture p30: schematic Screen.kicad_sch, ÉCRAN_RULER 2024]

Parts:
C13: 1uF; C_0603_1608Metric_Pad1.08x0.95mm_HandSolder
J3: Hirose_FH12-13S-0.5SH_1x13-1MP_P0.50mm_Horizontal
R12, R13, R14, R15, R16, R17: 10 k; R_0603_1608Metric_Pad0.98x0.95mm_HandSolder
R18: 20 - 25 ohm; R_0603_1608Metric_Pad0.98x0.95mm_HandSolder
SW3, SW4, SW5, SW6, SW7: CS1213AGF260; SW_CS1213AGF260_CRS

Connections:
AVDD: C13.1, J3.10 (VDD), R12.1, R13.1, R14.1, R16.1, R17.1, R18.1; also elsewhere on the board
Button1: R12.2, SW3.1; also elsewhere on the board
Button2: R13.2, SW4.1; also elsewhere on the board
Button3: R14.2, SW5.1; also elsewhere on the board
Button4: R16.2, SW6.1; also elsewhere on the board
Button5: R17.2, SW7.1; also elsewhere on the board
CS_Ecran: J3.7 (CS), R15.1; also elsewhere on the board
GND: C13.2, J3.8 (GND), J3.11 (LEDK), J3.13 (GND), R15.2, SW3.2, SW4.2, SW5.2, SW6.2, SW7.2; also elsewhere on the board
unnamed: J3.12 (LEDA), R18.2
RESET_Ecran: J3.6 (RESET); also elsewhere on the board
RS: J3.5 (RS); also elsewhere on the board
SPI_CLK: J3.4 (SCL); also elsewhere on the board
SPI_MOSI: J3.3 (SDA); also elsewhere on the board
Touch0: J3.1 (TP0); also elsewhere on the board
Touch1: J3.2 (TP1); also elsewhere on the board

Notes on the sheet:
NAVIGATIONEL BUTTON
PULL-DOWN
Connecteur Ecran

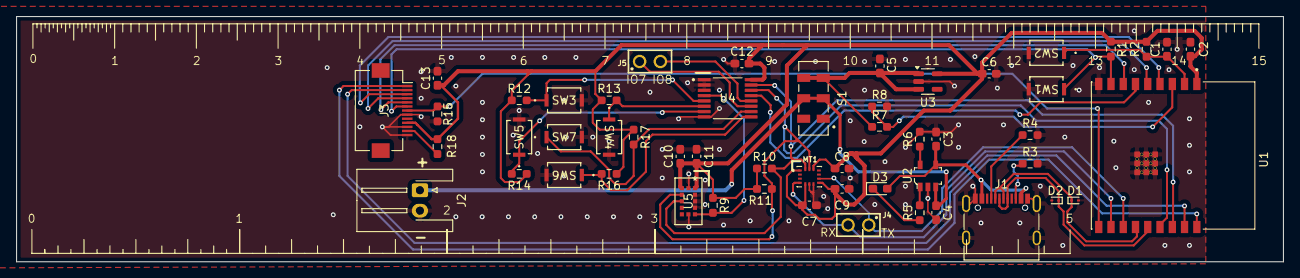
[picture p31: board PCB_Ruler_V1_2024.kicad_pcb from above]

Board: 2 copper layers, 155.0 x 30.0 mm, 53 parts (0 on the bottom side), 35 nets.
