Franky55/A24_ruler_Automne_2024/code/Version1/Ruler2024_Frank_Lau/includes/IMU_Processus.h

#ifndef IMU_PROCESSUS_H
#define IMU_PROCESSUS_H

#include "main.h"
#include "esp_log.h"

//Global variables
extern void (*IMU_function)(void);

//Functions
void InitializeIMUProcessus();
void GetAllAxes();

#endif
