Franky55/A24_ruler_Automne_2024/(commit log)

2024-10-14 Made kicad first push
    [PCB_Ruler_V1_2024.kicad_pcb, PCB_Ruler_V1_2024.kicad_sch]
2024-11-02 first actual push
    [Features.kicad_sch, MCU_ESP32-C3.kicad_sch, PCB_Ruler_V1_2024.kicad_sch, Power.kicad_sch, Screen.kicad_sch]
2024-11-03 battery charger
    [Features.kicad_sch, MCU_ESP32-C3.kicad_sch, Power.kicad_sch, Screen.kicad_sch]
2024-11-03 this is for my strong girl
    [Features.kicad_sch, Power.kicad_sch]
2024-11-04 regulator 3V3
    [Features.kicad_sch, MCU_ESP32-C3.kicad_sch, PCB_Ruler_V1_2024.kicad_sch, Power.kicad_sch, Screen.kicad_sch]
2024-11-05 Almost finished schematic...
    [Features.kicad_sch, MCU_ESP32-C3.kicad_sch, Power.kicad_sch, Screen.kicad_sch]
2024-11-05 protection and Buttons
    [Features.kicad_sch, MCU_ESP32-C3.kicad_sch, Screen.kicad_sch]
2024-11-07 started pcb
    [Features.kicad_sch, MCU_ESP32-C3.kicad_sch, PCB_Ruler_V1_2024.kicad_pcb, PCB_Ruler_V1_2024BomV1.csv, Power.kicad_sch, Screen.kicad_sch]
2024-11-07 pull down
    [Screen.kicad_sch]
2024-11-08 Hi handsome :)
    [Features.kicad_sch]
2024-11-12 modified pcb order
    [PCB_Ruler_V1_2024BomV1.csv]
2024-11-15 Je les ai mis ensemble mais pour les places en tant que tel pas sur , pas sur
    [PCB_Ruler_V1_2024.kicad_pcb]
2024-11-16 modifs :D
    [PCB_Ruler_V1_2024.kicad_pcb]
2024-11-18 started the pcb
    [Features.kicad_sch, PCB_Ruler_V1_2024.kicad_pcb, Power.kicad_sch]
2024-11-18 meeting miriam
    [PCB_Ruler_V1_2024.kicad_pcb]
2024-11-22 Added to schematic what was missing
    [Features.kicad_sch, MCU_ESP32-C3.kicad_sch, PCB_Ruler_V1_2024.kicad_pcb]
2024-11-22 hi sexy ;)
    [PCB_Ruler_V1_2024.kicad_pcb]
2024-11-22 PCB no errors
    [PCB_Ruler_V1_2024.kicad_pcb]
2024-11-23 last push before order
    [PCB_Ruler_V1_2024-B_Cu.gbr, PCB_Ruler_V1_2024-B_Mask.gbr, PCB_Ruler_V1_2024-B_Paste.gbr, PCB_Ruler_V1_2024-B_Silkscreen.gbr, PCB_Ruler_V1_2024-Edge_Cuts.gbr, PCB_Ruler_V1_2024-F_Cu.gbr, PCB_Ruler_V1_2024-F_Mask.gbr, PCB_Ruler_V1_2024-F_Paste.gbr]
2024-12-24 web site, buttons, IMU
2024-12-28 coucou v2
    [Features.kicad_sch, MCU_ESP32-C3.kicad_sch, PCB_Ruler_V1_2024.kicad_pcb, Power.kicad_sch, Screen.kicad_sch]
2024-12-28 Dernier push avant remise
    [PCB_Ruler_V1_2024BomV1.csv]
